gadepall/morse/main.tex

\documentclass[conference]{IEEEtran}
\usepackage{cite}
\usepackage{amsmath,amssymb,amsfonts}
\usepackage{graphicx}
\usepackage{textcomp}
\usepackage{xcolor}
\usepackage{listings}
\usepackage{url}
\usepackage{xurl}
\usepackage{hyperref}
\usepackage{tikz}
\usepackage{algorithm}
\usepackage{algpseudocode}
\usepackage{pgfplots}
\pgfplotsset{compat=1.17}
\usetikzlibrary{shapes,arrows,positioning,calc}

% Define a soft background color for the code blocks
\definecolor{codebg}{RGB}{245,245,248}

% Code listing style configuration
\lstset{
  language=C++,
  backgroundcolor=\color{codebg}, 
  basicstyle=\ttfamily\scriptsize, 
  keywordstyle=\color{blue},
  commentstyle=\color{green!60!black},
  stringstyle=\color{purple},
  breaklines=true,
  showstringspaces=false,
  frame=single,
  rulecolor=\color{gray!50}, 
  xleftmargin=0.5em,  
  xrightmargin=0.5em, 
  captionpos=b
}

\begin{document}

\title{A Morse Code-based Optical Communication System}
%\title{Adaptive Optical Telemetry: Evolving from Visible Light Baselines to Infrared Stepwise Derivative Thresholding and Goertzel Filtering}

\author{
    \IEEEauthorblockN{
Kartik Lahoti, Puni Aditya and G V V Sharma}
    \IEEEauthorblockA{Department of Electrical Engineering, \\Indian Institute of Technology Hyderabad,\\ Kandi, India 502284 \\ gadepall@ee.iith.ac.in}
    
}

\maketitle

\begin{abstract}
%Optical wireless communication offers a license-free alternative to Radio Frequency (RF) systems. However, simple visible light links utilizing Light Dependent Resistors (LDRs) face significant challenges regarding ambient light interference and hardware latency. 
This paper outlines a comprehensive multi-stage development of a Morse Code On-Off Keying (OOK) system. We first establish a baseline Visible Light Communication (VLC) link to demonstrate the fundamental principles of communication over an optical link.  
%, documenting a maximum range of 27 cm and identifying the "Iceberg Effect" of signal truncation. 
Subsequently, 
%Phase II 
we introduce 
%the transition to the 
Infrared (IR) 
communication to extend the range and explore more advanced techniques to improve the system performance. 
This is done by using the Arduino as the transceiver platform.  Our communication scheme is successfully demonstrated for a range of up to 2 meters.
%spectrum coupled with Dynamic Thresholding algorithm for adaptive thresholding, extending the range to 1.57 meters indoors. Finally, Phase III addresses the critical limitation of direct solar interference by implementing a fully software-defined 2~kHz carrier wave and a digital Goertzel filter, successfully rejecting DC solar saturation without requiring complex commercial hardware filters.
\end{abstract}

\begin{IEEEkeywords}
Visible Light Communication (VLC), Infrared (IR), Deynamic Thresholding, Goertzel Algorithm, On-Off Keying (OOK), Adaptive Thresholding.
\end{IEEEkeywords}

\section{Introduction}
Wireless optical communication is highly dependent on clear Line-of-Sight (LoS) and a high Signal-to-Noise Ratio (SNR) \cite{elgala2011, ghassemlooy2012}. In low-cost embedded systems, a standard Light Emitting Diode (LED) paired with a Light Dependent Resistor (LDR) is commonly used to demonstrate data transfer. However, ambient environmental lighting introduces a severe DC bias into the receiver, and LDRs exhibit significant photo-conductive latency \cite{sewaiwar2015}. 
The novelty of this paper lies in its evolutionary approach to solving physical layer limitations, building upon foundational On-Off Keying (OOK) optical paradigms \cite{komine2004}. We first establish a baseline VLC system to document hardware-induced signal degradation, known as the "Iceberg Effect." Following this, we introduce an advanced Infrared (IR) iteration utilizing Dynamic Thresholding—a software-defined algorithm that tracks the environmental noise floor \cite{green2005}. Finally, to overcome severe outdoor solar interference \cite{rajagopal2012}, we introduce a Goertzel algorithm-based digital signal processing (DSP) approach, effectively turning a low-cost microcontroller into a software-defined radio for optical frequencies.

\subsection{Related Works and Novelty}
Standard commercial IR systems avoid ambient noise by utilizing 38kHz Carrier Waves and specialized TSOP receiver modules. While effective, these modules act as "black boxes" that strip the analog signal data away from the microcontroller, preventing custom low-level signal analysis. Conversely, standard unmodulated photodiode circuits use fixed analog thresholds that fail the moment room lighting changes. Our proposed Dynamic Thresholding and Goertzel implementations bridge this gap, retaining raw analog sampling while applying dynamic digital filters to reject ambient DC bias. The related block diagram is available in 
    Fig. \ref{fig:block}
\begin{figure}[htbp]
    \centering
    \resizebox{\columnwidth}{!}{
    \begin{tikzpicture}[node distance=1.2cm, auto, >=stealth]
        \tikzstyle{block} = [rectangle, draw, fill=blue!10, text width=6em, text centered, rounded corners, minimum height=3em]
        \tikzstyle{line} = [draw, -latex', thick]
        
        % TX Nodes
        \node [block] (mcu1) {TX MCU\\(Morse Encoder)};
        \node [block, right=of mcu1] (led) {LED/IR LED\\(OOK Driver)};
        
        % Channel
        \node [coordinate, right=2.5cm of led] (ch1) {}; 
        \node [coordinate, below=1.5cm of ch1] (ch2) {};
        
        % RX Nodes
        \node [block, below=1.5cm of led] (sensor) {LDR/PD\\(Voltage Divider)};
        \node [block, left=of sensor] (adc) {ADC\\(Sampling)};
        \node [block, below=of adc] (sdm) {Dynamic Threshold/Goertzel\\(Digital Filter)};
        \node [block, right=of sdm] (decoder) {Symbol\\Decoder};
        \node [block, right=of decoder] (disp) {7-Segment\\Display};

        % Paths
        \path [line] (mcu1) -- node {Digital} (led);
        \path [line, dashed, red] (led) -- node[above] {Optical Channel} (ch1) -- (ch2) -- (sensor);
        \path [line] (sensor) -- node[above] {Analog} (adc);
        \path [line] (adc) -- (sdm);
        \path [line] (sdm) -- node[above] {Pulses} (decoder);
        \path [line] (decoder) -- node[above] {Char} (disp);
    \end{tikzpicture}
    }
    \caption{System Block Diagram detailing the cross-layer flow from hardware transmission to the software-defined filtering and hardware output.}
    \label{fig:block}
\end{figure}
%\section{Hardware Configuration}

To ensure reproducibility, the system was tested using standard off-the-shelf components. The development was split into two hardware profiles as detailed in Table \ref{tab:components}.
\begin{table}[htbp]
\caption{List of Components}
\label{tab:components}
\centering
\begin{tabular}{|l|l|}
\hline
\textbf{Setup} & \textbf{Components} \\ \hline
\textbf{Common} & 2$\times$ Arduino UNO, \\
&  2$\times$ Breadboards, \\
& Resistors, \\
& Jumper Cables \\ \hline
\textbf{Visible} & 1$\times$ Red LED ($5\text{mm}$), \\
& 1$\times$ LDR ($5\text{mm}$) \\ \hline
\textbf{IR} & 1$\times$ 940-nm IR LED, \\
& 1$\times$ IR Photodiode (Reverse Bias) \\ \hline
\end{tabular}
\end{table}

\subsection{Baud Rate and Telemetry Applicability}
Morse code, utilizing OOK, possesses a fundamentally low baud rate compared to modern digital modulation schemes like UART or QAM. However, for specialized telemetry applications—such as underwater optical communication or low-cost sensor nodes—signal penetration and robustness take precedence over raw speed. The widened tolerance windows used in this paper's decoding logic demonstrate how low baud rate systems can reliably reconstruct highly degraded signals \cite{uysal2015}.

\section{System Model}
\subsection{Baseband Morse Encoding}
To establish a quantitative baseline for On-Off Keying (OOK) modulation, the system utilizes the standard international Morse code protocol. In this telemetry model, the transmitter's digital output pin toggles between a HIGH (active) and LOW (idle) state to construct characters. 

The protocol defines all signal durations relative to a single base time unit ($T_u$), which in our experimental setup is set to $200\text{ ms}$. The strict timing rules governing this variable-length baseband modulation are detailed in Table \ref{tab:morse_timing}. 

\begin{table}[htbp]
\caption{Standard Morse Protocol Timings ($T_u = 200\text{ ms}$)}
\label{tab:morse_timing}
\centering
\begin{tabular}{|l|c|l|}
\hline
\textbf{Protocol Element} & \textbf{Logic State} & \textbf{Duration} \\ \hline
Dot (Dit)                 & HIGH (ON)            & 1 $T_u$ ($200\text{ ms}$) \\ \hline
Dash (Dah)                & HIGH (ON)            & 3 $T_u$ ($600\text{ ms}$) \\ \hline
Intra-character gap       & LOW (OFF)            & 1 $T_u$ ($200\text{ ms}$) \\ \hline
Inter-character gap       & LOW (OFF)            & 3 $T_u$ ($600\text{ ms}$) \\ \hline
Inter-word gap            & LOW (OFF)            & 7 $T_u$ ($1400\text{ ms}$) \\ \hline
\end{tabular}
\end{table}

This baseband square wave serves as the fundamental logic envelope for all subsequent experimental phases. A visual representation of these timing constraints is illustrated in Fig. \ref{fig:morse_an} for the transmission of the word "AN".
\begin{figure}[htbp]
    \centering
    \resizebox{\columnwidth}{!}{
    \begin{tikzpicture}[scale=0.6]
        % Axes
        \draw[->] (-0.5,0) -- (14,0) node[right] {Time ($T_u$)};
        \draw[->] (0,-0.5) -- (0,2) node[above] {TX Pin Logic};

        % Ticks
        \foreach \x in {1,2,3,4,5,6,7,8,9,10,11,12,13}
            \draw (\x,0.1) -- (\x,-0.1) node[below, scale=0.7] {\x};

        % Logic High/Low labels
        \node[left, scale=0.8] at (0, 1) {HIGH (1)};
        \node[left, scale=0.8] at (0, 0.25) {LOW (0)};

        % Waveform for "A" (.-) and "N" (-.)
        \draw[thick, blue]
            (0,0) -- (0,1) -- (1,1)   % A: dit
            -- (1,0) -- (2,0)         % intra-gap
            -- (2,1) -- (5,1)         % A: dah
            -- (5,0) -- (8,0)         % inter-character gap
            -- (8,1) -- (11,1)        % N: dah
            -- (11,0) -- (12,0)       % intra-gap
            -- (12,1) -- (13,1)       % N: dit
            -- (13,0) -- (14,0);      % return to idle

        % Annotations
        \draw[<->, dashed, red] (0, 1.4) -- (5, 1.4) node[midway, above] {Letter 'A' ( $\cdot$ $\textbf{-}$ )};
        \draw[<->, dashed, red] (8, 1.4) -- (13, 1.4) node[midway, above] {Letter 'N' ( $\textbf{-}$ $\cdot$ )};
        \draw[<->, dashed, green!50!black] (5, 0.5) -- (8, 0.5) node[midway, above, scale=0.8] {3-$T_u$ Gap};

    \end{tikzpicture}
    }
    \caption{Baseband OOK transmission waveform for the word "AN", illustrating the strict 1:3 timing ratio of standard Morse protocol.}
    \label{fig:morse_an}
\end{figure}

\subsection{Hardware Setup}
    Fig. \ref{fig:ckt} shows the transceiver configuration used for various cases.  
\begin{itemize}
    \item Transmitter (TX): An Arduino microcontroller drives a standard visible/IR LED. The LED's anode connects to Digital Pin 5, while the cathode is grounded through a $220\Omega$ current-limiting resistor. 
    \item Receiver (RX): The optical sensor is a Light Dependent Resistor (LDR)/IR receiver (connected in reverse bias) arranged in a voltage divider. The 5V supply is connected to one leg of the receiver. The secondary leg connects to the Arduino's Analog Pin A0 and a pull-down resistor ($R$) connected to ground. 
\end{itemize}
    The corresponding details are available in 
Table \ref{tab:res_vs_dist}.
\begin{figure}[htbp]
    \centering
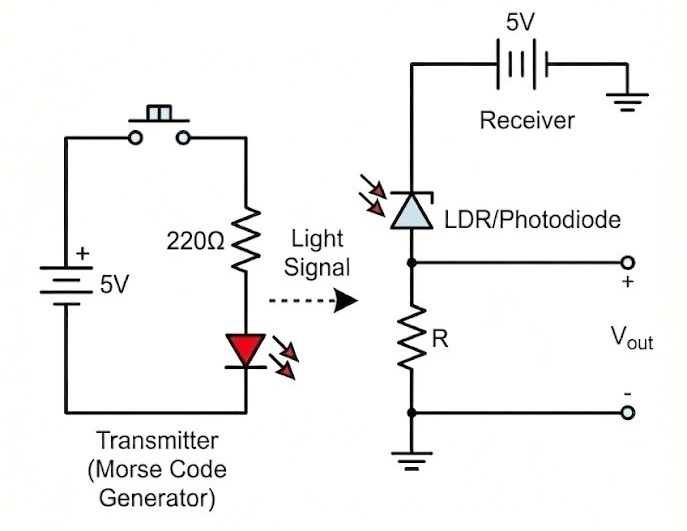
[picture p1: figs/circuit.jpeg]
    
    \caption{Circuit Diagram}
    \label{fig:ckt}
\end{figure}

\begin{table}[htbp]
\caption{Maximum Reliable Distance vs. Load Resistance}
\label{tab:res_vs_dist}
\centering
\begin{tabular}{|l|c|l|}
\hline
\textbf{Configuration} & \textbf{Load Resistor ($R$)} & \textbf{Maximum Range} \\ \hline
Visible Light & 10 k$\Omega$ & 27 cm \\ 
(LDR) & & \\ \hline
Baseband IR & 10 k$\Omega$ & $\approx$ 50 cm (47 cm) \\ \hline
Baseband IR & 1 M$\Omega$ & $\approx$ 2 m (157 cm) \\ \hline
Frequency- & 1 M$\Omega$ & $>$ 2 m (Slightly better) \\ 
Modulated IR & & \\ \hline
\end{tabular}
\end{table}

\section{Communication System}

\subsection{Visible Light Baseline}
%\subsubsection{Hardware Latency and The "Iceberg Effect"}
When bridging analog optical sensing and digital microcontrollers, signal truncation occurs. As shown in Fig. \ref{fig:iceberg}, an expected "Dah" signal transmitted for 600ms is detected for a fraction of that time. LDRs exhibit notable rise/fall latency, resulting in a trapezoidal curve. To counteract this, our receiver employs widened tolerance windows as listed in Table \ref{tab:morse_timing-modified}.
The baseline system achieved a maximum reliable transmission distance of only 11-12 cm in room light, and 27 cm in total darkness.
\begin{figure}[htbp]
    \centering
    \resizebox{\columnwidth}{!}{
    \begin{tikzpicture}[scale=0.8]
        \draw[->] (0,0) -- (8,0) node[right] {Time (ms)};
        \draw[->] (0,0) -- (0,5) node[above] {Analog Value};
        \draw[thick, blue, fill=blue!10] (0,0) -- (1.5,0) -- (2.5,4) -- (5.5,4) -- (7.5,0) -- (8,0);
        \node[blue] at (4, 2) {LDR Response Profile};
        \draw[red, thick, dashed] (0,3.5) -- (8,3.5);
        \node[red, right] at (8,3.5) {High Static Threshold};
        \draw[green!60!black, thick, dashed] (0,1.5) -- (8,1.5);
        \node[green!60!black, right] at (8,1.5) {Ideal Threshold};
        \draw[dotted, red] (2.375, 3.5) -- (2.375, -0.5); 
        \draw[dotted, red] (5.75, 3.5) -- (5.75, -0.5); 
        \draw[dotted, green!60!black] (1.875, 1.5) -- (1.875, -1);   
        \draw[dotted, green!60!black] (6.75, 1.5) -- (6.75, -1);   
        \draw[<->, red, thick] (2.375, -0.5) -- (5.75, -0.5) node[midway, below] {Detected: $\approx$330ms};
        \draw[<->, green!60!black, thick] (1.875, -1) -- (6.75, -1) node[midway, below] {Actual: $\approx$600ms};
    \end{tikzpicture}
    }
    \caption{The "Iceberg Effect" illustrating temporal truncation caused by improper static thresholding of an LDR signal.}
    \label{fig:iceberg}
\end{figure}

\begin{table}[htbp]
\caption{Adaptive Morse Protocol Timings to combat "Iceberg Effect"}
\label{tab:morse_timing-modified}
\centering
\begin{tabular}{|l|c|l|}
\hline
\textbf{Protocol Element} & \textbf{Logic State} & \textbf{Duration} \\ \hline
Dot (Dit)                 & HIGH (ON)            &  $150\text{ ms}$ \\ \hline
Dash (Dah)                & HIGH (ON)            &  $450\text{ ms}$ \\ \hline
Intra-character gap       & LOW (OFF)            &  $350\text{ ms}$ \\ \hline
Inter-character gap       & LOW (OFF)            &  $750\text{ ms}$ \\ \hline
Inter-word gap            & LOW (OFF)            &  $1600\text{ ms}$ \\ \hline
\end{tabular}
\end{table}
Instructions for flashing the firmware on the Arduinos for setting up the communication system are available in Appendix \ref{app:hardware}.

\subsection{Infrared Evolution and Dynamic Thresholding}

\begin{figure}[htbp]
    \centering
    % \resizebox forces the diagram to fit the column width exactly.
    % Requires \usepackage{graphicx} in your preamble.
    \resizebox{0.7\columnwidth}{!}{%
    \begin{tikzpicture}[
        auto, 
        node distance=0.8cm, % Reduced vertical/horizontal spacing
        >=latex,
        % Added font=\small to reduce text footprint
        block/.style={rectangle, draw, align=center, minimum height=2.5em, fill=gray!10, rounded corners=2pt, font=\small},
        sum/.style={draw, circle, minimum size=1.5em, inner sep=0pt, font=\large} % Style for the + symbol
    ]

        % 1. Define Nodes
        \node (analog) {$x(t)$};
        \node [block, right=0.4cm of analog] (adc) {ADC};
        
        % Split coordinate for the bypass line
        \node [coordinate, right=0.6cm of adc] (split) {};
        
        % Main vertical processing stack
        \node [block, right=0.6cm of split] (filter) {Moving Average\\Filter (Size $N$)};
        \node [sum, below=0.8cm of filter] (adder) {$+$}; % <-- Replaced Adder block with + symbol
        \node [block, below=0.8cm of adder] (comp) {Threshold\\($x[n] \gtrless \tau[n]$)}; 
        
        % Margin tucked closely to the right
        \node [block, right=0.4cm of adder] (margin) {Margin\\($\sigma$)};
        
        % Output moved BELOW the comparator to save horizontal space
        \node [block, below=0.6cm of comp] (output) {Output\\(H/L)};

        % 2. Draw Routing Paths
        % Analog input into ADC
        \draw [->] (analog) -- (adc);
        
        % ADC output to the split, labeled as the discrete x[n] sequence
        \draw [-] (adc) -- node[above, font=\small] {$x[n]$} (split);
        
        % Top path into filter
        \draw [->] (split) -- (filter.west);
        
        % Bypass line drops straight down from the split, then turns right into comparator
        \draw [->] (split) |- (comp.west);

        % Vertical logic flow
        \draw [->] (filter.south) -- node[left, font=\small] {$\mu[n]$} (adder.north);
        \draw [->] (adder.south) -- node[left, font=\small] {$\tau[n]$} (comp.north);
        
        % Side connections
        \draw [->] (margin.west) -- (adder.east);
        
        % Output connection (now vertical)
        \draw [->] (comp.south) -- (output.north);

    \end{tikzpicture}%
    }
    \caption{Block Diagram of Receiver used in IR with Dynamic Thresholding}
    \label{fig:dynamic_threshold_adc}
\end{figure}

\subsubsection{Hardware Optimization and Adaptive Filtering}
Operating in reverse-bias, the photodiode produces a photocurrent ($I_{pd}$) proportional to the incident photon flux; consequently, the voltage sampled by the ADC is governed by $V_{adc} = I_{pd} \times R$. By increasing $R$ from $10\text{ k}\Omega$ to $1\text{ M}\Omega$, sensitivity was maximized, extending the raw range to 1.57 meters indoors.

To isolate transmission pulses from fluctuating indoor IR noise, we implement a discrete-time Dynamic Thresholding algorithm. The core challenge is that the photodiode's ambient baseline is not zero; it is a floating DC offset that shifts as environmental lighting changes. To track this, the receiver converts the continuous-time analog voltage $x(t)$ into a discrete-time sequence by polling the Analog-to-Digital Converter (ADC) at designated intervals. Let $T_s$ represent this sampling period. The discrete sample index $n$ maps directly to physical continuous time via the relation $t = n T_s$, defining our sampled sequence as $x[n] = x(n T_s)$. 

The algorithm calculates a rolling local mean, over a circular buffer of $N$ samples to capture the slow-moving ambient noise floor:
\begin{equation}
    \tau[n] = \frac{1}{N} \sum_{i=0}^{N-1} x[n-i] + \sigma \label{eq:thres}
\end{equation}

This moving average inherently acts as a digital low-pass filter. To extract the high-frequency OOK pulses, a dynamic threshold $\tau[n]$ is established by adding a constant margin $\sigma$ to the local mean:

By dynamically adjusting the threshold relative to the moving baseline, the detection zone floats alongside ambient light shifts. The logic implementation is detailed in Algorithm \ref{alg:dynamic_threshold}, and the discrete sampling behavior is visualized in Fig. \ref{fig:dynamic_graph}.

\begin{algorithm}[htbp]
\caption{Dynamic Thresholding for OOK Demodulation}
\label{alg:dynamic_threshold}
\begin{algorithmic}[1]
\Require Discrete input sequence $x[n]$, Window size $N$, Margin $\sigma$
\State Initialize circular buffer $B$ of size $N$ to 0
\State Initialize running sum $S \leftarrow 0$
\For{each strictly timed sampling interval $n$}
    \State $S \leftarrow S - B[n \bmod N]$ \Comment{Remove oldest sample}
    \State $B[n \bmod N] \leftarrow x[n]$ \Comment{Insert new sample}
    \State $S \leftarrow S + x[n]$
    \State $\mu[n] \leftarrow S / N$ \Comment{Calculate local mean}
    \State $\tau[n] \leftarrow \mu[n] + \sigma$ \Comment{Set floating threshold}
    \If{$x[n] > \tau[n]$}
        \State Register logical HIGH (Pulse active)
    \Else
        \State Register logical LOW (Idle)
    \EndIf
\EndFor
\end{algorithmic}
\end{algorithm}

\begin{figure}[htbp]
    \centering
    \resizebox{\columnwidth}{!}{
    \begin{tikzpicture}[scale=1]
        % Axes
        \draw[->, thick] (-1,0) -- (68,0) node[right] {Sample ($n$)};
        \draw[->, thick] (0,-0.5) -- (0,6.8) node[above] {Amplitude};

        % Axis Ticks
        \foreach \x in {0, 10, 20, 30, 40, 50, 60} {
            \draw[thick] (\x, 0.1) -- (\x, -0.1) node[below, scale=0.8] {\x};
        }
        \node[below, scale=0.9] at (30, -0.7) {Discrete Sample Index ($n$) mapping to $t = n T_s$ ($T_s = 20$ ms)};

        % Local Mean - Rises VERY slowly because the buffer is massive (N=500)
        \draw[blue, thick] (0,0.5) .. controls (30,0.6) .. (65,0.8) node[right, align=center, scale=0.8] {Local Mean\\$\mu[n]$ (N=500)};

        % Dynamic Threshold
        \draw[red, thick, dashed] (0,2.0) .. controls (30,2.1) .. (65,2.3) node[right, align=center, scale=0.8] {Threshold\\$\tau[n]$};

        % Continuous underlying signal x(t) simulating exactly 'H' (....)
        \draw[orange!70, thick, rounded corners=1.5pt]
            (0, 0.5) -- (9.5, 0.6) % Initialization noise
            -- (9.8, 5.0) -- (19.2, 5.0) % Dit 1
            -- (19.5, 0.6) -- (29.5, 0.7) % Gap 1
            -- (29.8, 5.1) -- (39.2, 5.1) % Dit 2
            -- (39.5, 0.7) -- (49.5, 0.8) % Gap 2
            -- (49.8, 5.0) -- (59.2, 5.0) % Dit 3
            -- (59.5, 0.8) -- (65, 0.9);  % Gap 3

        \node[orange!90!black, above, scale=0.8] at (14, 3.5) {Continuous $x(t)$};

        % Discrete Signal Stems & Points x[n]
        % Exact 10-sample resolution per Tu (200ms Tu / 20ms Ts = 10 samples)
        \foreach \x in {0,1,...,9}   { \draw[gray, thin] (\x,0) -- (\x,0.55); \filldraw[black] (\x,0.55) circle (1.2pt); }
        \foreach \x in {10,11,...,19} { \draw[gray, thin] (\x,0) -- (\x,5.0); \filldraw[black] (\x,5.0) circle (1.2pt); }
        \foreach \x in {20,21,...,29} { \draw[gray, thin] (\x,0) -- (\x,0.65); \filldraw[black] (\x,0.65) circle (1.2pt); }
        \foreach \x in {30,31,...,39} { \draw[gray, thin] (\x,0) -- (\x,5.1); \filldraw[black] (\x,5.1) circle (1.2pt); }
        \foreach \x in {40,41,...,49} { \draw[gray, thin] (\x,0) -- (\x,0.75); \filldraw[black] (\x,0.75) circle (1.2pt); }
        \foreach \x in {50,51,...,59} { \draw[gray, thin] (\x,0) -- (\x,5.0); \filldraw[black] (\x,5.0) circle (1.2pt); }
        \foreach \x in {60,61,...,65} { \draw[gray, thin] (\x,0) -- (\x,0.85); \filldraw[black] (\x,0.85) circle (1.2pt); }

        % Timings annotations matching Arduino Code variables
        \draw[<->, thick, black!70] (10, 5.4) -- (19, 5.4) node[midway, above, scale=0.8] {Dit (1 $T_u$ = 10 samples)};
        \draw[<->, thick, black!70] (20, 1.2) -- (29, 1.2) node[midway, above, scale=0.8] {Intra-char Gap};
        \draw[<->, thick, black!70] (30, 5.5) -- (39, 5.5) node[midway, above, scale=0.8] {Dit (10 samples)};
        
        % Main character annotation
        \draw[<->, thick, blue!70!black] (10, 6.2) -- (59, 6.2) node[midway, above, scale=0.9] {\textbf{Start of 'H' (....) from "HELLO WORLD"}};

    \end{tikzpicture}
    }
    \caption{Exact mathematical mapping of the "HELLO WORLD" sequence. With a base time unit $T_u = 200$ ms and sample interval $T_s = 20$ ms, each standard Dit and Gap captures precisely 10 discrete samples. Because the buffer size is massive ($N=500$), the local mean $\mu[n]$ remains highly stable and does not climb high enough to clip the signal during pulses, completely preventing baseline wander.}
    \label{fig:dynamic_graph}
\end{figure}

% \subsubsection{Initialization and Training Sequence}
% Because the rolling buffer requires a stabilization period to accurately map the ambient noise floor, the system mandates an initialization phase prior to data transmission. The system starts with an assumed signal margin ($\sigma$), detailed in Table \ref{tab:assumed_thresholds}, to bootstrap the detection logic. During this phase, a known training sequence ("HELLO WORLD") is transmitted 10 times. 

% \begin{table}[htbp]
% \caption{Initial Assumed Threshold Margins ($\sigma$) Prior to Stabilization}
% \label{tab:assumed_thresholds}
% \centering
% \begin{tabular}{|l|c|l|}
% \hline
% \textbf{Ambient Environment} & \textbf{Assumed Margin ($\sigma$)} & \textbf{ADC Voltage Equivalent} \\ \hline
% Total Darkness & 30 & $\approx 0.15\text{V}$ \\ \hline
% Standard Indoor Lighting & 80 & $\approx 0.39\text{V}$ \\ \hline
% High Ambient (Near Window) & 150 & $\approx 0.73\text{V}$ \\ \hline
% \end{tabular}
% \end{table}

% Based on the timing ratios defined in Table \ref{tab:morse_timing}, this full 10-cycle training sequence spans 1110 $T_u$, equating to a deliberate 222-second pre-transmission window. This ensures the filter buffer fully saturates with representative environmental data before processing unknown payloads.

\subsubsection{Dynamic Thresholding Initialization and Training Sequence}
Because the rolling buffer requires a stabilization period to accurately map the ambient noise floor, the system mandates an initialization phase prior to data transmission. Initially, the system starts with an assumed, pre-defined threshold for the signal margin ($\sigma$), detailed in Table \ref{tab:assumed_thresholds}, to bootstrap the detection logic based on the expected ambient environment. During this initialization phase, a known training sequence—the phrase "HELLO WORLD"—is transmitted 10 times. 

\begin{table}[htbp]
\caption{Initial Assumed Signal Margins ($\sigma$) Prior to Stabilization (1 M$\Omega$ Setup)}
\label{tab:assumed_thresholds}
\centering
\begin{tabular}{|l|c|l|}
\hline
\textbf{Ambient Environment} & \textbf{Assumed Margin ($\sigma$)} & \textbf{ADC Voltage} \\ 
& & \textbf{Eqv. (5V)} \\ \hline
Total Darkness & 30 & $\approx 0.15\text{V}$ \\ \hline
Standard Indoor & 80 & $\approx 0.39\text{V}$ \\ 
Lighting & & \\ \hline
High Ambient & 150 & $\approx 0.73\text{V}$ \\ 
(Near Window)  & & \\ \hline
\end{tabular}
\end{table}

Based on the timing ratios defined in Table \ref{tab:morse_timing}, a single transmission of "HELLO WORLD" consumes exactly 111 $T_u$ (inclusive of all intra-character, inter-character, and inter-word gaps). Therefore, the full 10-cycle training sequence spans 1110 $T_u$. Given our baseline $T_u = 200\text{ ms}$, this equates to a deliberate 222-second pre-transmission window. This ensures the Dynamic Thresholding buffer ($V_{noise}$) fully saturates with representative environmental data, allowing the dynamic baseline to settle completely alongside the assumed margin before the receiver attempts to decode unknown payload characters.

\section{Amplitude Modulation}

\subsection{Limitations of Baseband Detection in Sunlight}
While unmodulated IR transmission functions indoors, it fails in direct sunlight. The sun acts as a continuous, high-intensity IR source that drives a massive steady-state photocurrent, saturating the receiver's 10-bit ADC and eliminating the dynamic range needed to detect Morse pulses. 

To prevent this "hard" saturation outdoors, the receiver's load resistor can be decreased (e.g., from $1\text{M}\Omega$ to $10\text{k}\Omega$). While this keeps the solar DC component within measurable bounds, it severely degrades the signal-to-noise ratio (SNR), reducing the intentional pulses to minute fluctuations on a massive DC floor. Recovering this attenuated signal requires transitioning from baseband amplitude tracking to frequency-selective filtering.

\subsection{Modulation}
To isolate the data from the solar baseline, we implement On-Off Keying (OOK), a fundamental form of Amplitude Modulation (AM). Instead of emitting a static DC pulse, the transmitter modulates the IR LED with a 2~kHz square wave carrier during every active Morse symbol.

This modulation shifts the transmission into the frequency domain:
\begin{itemize}
    \item \textbf{DC Offset (Sun):} Solar interference remains concentrated at 0~Hz.
    \item \textbf{Data Signal:} The Morse pulses are nested inside a 2000~Hz carrier band.
\end{itemize}
By toggling the LED at 2~kHz, the receiver can selectively filter out the 0~Hz solar bias and evaluate only the oscillating AC energy. Operating at a 50\% duty cycle also halves the active transmission power, extending battery life for remote nodes.

\begin{figure}[htbp]
    \centering
    \begin{tikzpicture}[scale=1]
        % Axes
        \draw[->] (0,0) -- (6,0) node[right] {Time};
        \draw[->] (0,-0.5) -- (0,1.5) node[above] {Amplitude};
        
        % Logic Envelope (Dashed)
        \draw[red, thick] (0,0) -- (1,0) -- (1,1) -- (3,1) -- (3,0) -- (4,0) -- (4,1) -- (5,1) -- (5,0);
        \node[red, scale=0.8] at (2,1.2) {Morse 'A' Envelope (.-)};

        % 2~kHz Square Wave Modulated Carrier (Dah)
        \draw[blue] (1,0) -- (1.1,0) -- (1.1,1) -- (1.2,1) -- (1.2,0) -- (1.3,0) -- (1.3,1) -- (1.4,1) -- (1.4,0) -- (1.5,0) -- (1.5,1) -- (1.6,1) -- (1.6,0) -- (1.7,0) -- (1.7,1) -- (1.8,1) -- (1.8,0) -- (1.9,0) -- (1.9,1) -- (2.0,1) -- (2.0,0) -- (2.1,0) -- (2.1,1) -- (2.2,1) -- (2.2,0) -- (2.3,0) -- (2.3,1) -- (2.4,1) -- (2.4,0) -- (2.5,0) -- (2.5,1) -- (2.6,1) -- (2.6,0) -- (2.7,0) -- (2.7,1) -- (2.8,1) -- (2.8,0) -- (2.9,0) -- (2.9,1) -- (3.0,1) -- (3.0,0);
        
        % 2~kHz Square Wave Modulated Carrier (Dit)
        \draw[blue] (4,0) -- (4.1,0) -- (4.1,1) -- (4.2,1) -- (4.2,0) -- (4.3,0) -- (4.3,1) -- (4.4,1) -- (4.4,0) -- (4.5,0) -- (4.5,1) -- (4.6,1) -- (4.6,0) -- (4.7,0) -- (4.7,1) -- (4.8,1) -- (4.8,0) -- (4.9,0) -- (4.9,1) -- (5.0,1) -- (5.0,0);
        
        \node[blue, align=center, scale=0.8] at (4.5,1.5) {2~kHz Square Wave\\Carrier};
        \node[red, align=center, scale=0.8] at (3,-0.3) {0~Hz Solar Bias Ignored};
    \end{tikzpicture}
    \caption{Amplitude Modulation: The Morse envelope gates a 2~kHz subcarrier, enabling frequency-selective filtering at the receiver.}
    \label{fig:modulation}
\end{figure}

\subsection{Demodulation}

\subsubsection{Receiver}
To detect the 2~kHz carrier digitally, the ADC prescaler is reduced from 128 to 16, accelerating the sampling rate ($f_s$) to $\approx 60\text{ kHz}$. This massive oversampling provides the resolution necessary for the Goertzel algorithm \cite{smith1997}, which we utilize as a computationally lightweight digital bandpass filter. 

The receiver pipeline is illustrated in Fig. \ref{fig:modulated_block}. For a given target frequency index $k$ and block size $N$, the algorithm computes the intermediate state $y[n]$ for each incoming sample $x[n]$ using the second-order difference equations \cite{goertzel}:
\begin{align}
    s[n] &= x[n] + 2 \cos\left(\frac{2\pi k}{N}\right) s[n-1] - s[n-2] \\
    y[n] &= s[n] - e^{-j\omega_{0}} s[n-1]
\end{align}
where $y[-1] = y[-2] = 0$ and $\omega_0 = \frac{2\pi k}{N}$.

\begin{figure}[htbp]
\centering
\resizebox{0.9\columnwidth}{!}{%
\begin{tikzpicture}[
    auto,
    block/.style={rectangle, draw, thick, text width=2.2cm, align=center, minimum height=1.2cm},
    arrow/.style={-stealth, thick}
]
% Top Row Nodes
\node (xt) {$x(t)$};
\node[block, right=0.8cm of xt] (adc) {ADC\\($f_s \approx 60$\,kHz)};
\node[block, right=1.4cm of adc] (bpf) {Goertzel\\Filter};

% Bottom Row Nodes
\node[block, below=1.0cm of bpf] (mag) {Magnitude\\Eval ($M^2$)};
\node[block, left=1.4cm of mag] (thresh) {$M^2 \gtrless \tau_{mag}$};
\node[left=0.8cm of thresh, align=center] (out) {Output};

% Arrows
\draw[arrow] (xt) -- (adc);
\draw[arrow] (adc) -- node[above] {$x[n]$} (bpf);
\draw[arrow] (bpf) -- node[right] {$y[n]$} (mag);
\draw[arrow] (mag) -- node[above] {$M^2$} (thresh);
\draw[arrow] (thresh) -- (out);
\end{tikzpicture}%
}
\caption{Block Diagram for Modulated IR Receiver ($\tau_{mag} = 15000$)}
\label{fig:modulated_block}
\end{figure}

After processing $N$ samples, the squared spectral magnitude $M^2$ at the target frequency is extracted:
\begin{align}
    M^2 &= y^2[N-1] + y^2[N-2] \\ 
	&- 2 \cos\left(\frac{2\pi k}{N}\right) y[N-1] y[N-2]
\end{align}

Using the squared magnitude bypasses the computational cost of floating-point square roots. 

A block size of $N=80$ provides a processing window of $\approx 1.33\text{ ms}$, ensuring temporal responsiveness for decoding Morse timings. This creates a bin resolution ($\Delta f = f_s / N$) of $750\text{ Hz}$. The index $k = \text{round}(N \cdot f_{target} / f_s) = 3$ centers the filter at $2250\text{ Hz}$. This wide main lobe comfortably captures the $2000\text{ Hz}$ carrier while aggressively suppressing out-of-band signals like 0~Hz DC sunlight and 120~Hz AC flicker.

\subsubsection{Static Thresholding and OOK Demodulation}
While $M^2$ theoretically approaches zero during transmission gaps, ADC quantization and thermal noise establish a low-level baseline. We apply an empirical static threshold ($\tau_{mag} = 15000$) to digitize the signal. 

Because constructive interference from a valid 2~kHz carrier produces $M^2$ values on the order of $10^5$, this threshold safely clears the noise floor while maintaining sensitivity to distant transmissions. The real-time OOK demodulation operates as a binary slicer:
\begin{equation}
    \text{Pulse Detected} = \begin{cases} 
      \text{True (HIGH)}, & \text{if } M^2 > \tau_{mag} \\
      \text{False (LOW)}, & \text{otherwise} 
   \end{cases}
\end{equation}
By filtering out the wandering DC bias mathematically, the Goertzel algorithm ensures absolute baseline stability. This eliminates the need for complex adaptive thresholding and allows robust OOK demodulation under variable lighting conditions.

\section{Experimental Results}

\subsection{Throughput and Bitrate Analysis}
We evaluated the efficiency of the three methods by transmitting a 44-byte (352-bit) test sentence. While the VLC setup required slower custom timings (101.8s) to account for photo-conductive latency, the transition to standard Morse timing in IR and Frequency-Modulated IR communication significantly improved throughput. Because Morse code utilizes variable-length OOK encoding, instantaneous throughput fluctuates based on character transmission length. A 44-byte pangram was explicitly chosen as the test payload to force the transmission of all alphabet symbol variants, thereby providing a normalized, worst-case representative average for system bitrate.

\begin{table}[htbp]
\caption{System Performance Comparison (44-Byte Sentence)}
\label{tab:bps}
\centering
\begin{tabular}{|l|c|c|l|}
\hline
\textbf{Receiver Mode of } & \textbf{Time (s)} & \textbf{Bitrate (bps)} & \textbf{Environment} \\ 
\textbf{Communication} & & \\ \hline
Visible Light & 101.8 & 3.46 & Dark/Indoor only \\ \hline
Baseband IR  & 81.4 & 4.32 & Indoor (Non-Solar) \\ \hline
Frequency- & 81.4 & 4.32 & \textbf{Direct Sunlight} \\ 
Modulated IR  & & \\ \hline
\end{tabular}
\end{table}

As shown in Table \ref{tab:bps}, Frequency-Modulated IR maintains the peak bitrate of 4.32 bps even in high-solar environments where VLC and Baseband IR systems experience complete signal saturation and $<10$\% decoding accuracy.

\subsection{Range Analysis}
The integration of impedance-tuned hardware with software-defined filtering yielded profound improvements. As illustrated in Fig. \ref{fig:graph}, the visible light baseline failed abruptly at 27 cm. The unoptimized IR setup ($10\text{k}\Omega$) reached 47 cm. The fully optimized IR-Dynamic Thresholding setup ($1\text{M}\Omega$) successfully maintained 100\% decoding accuracy up to 157 cm indoors. Decoding accuracy was empirically measured as the percentage of correctly reconstructed characters from the 44-byte test payload at varying distances.

\begin{figure}[htbp]
    \centering
    \resizebox{0.9\columnwidth}{!}{
    \begin{tikzpicture}
        \begin{axis}[
            xlabel={Transmission Distance (cm)},
            ylabel={Decoding Accuracy (\%)},
            xmin=0, xmax=180,
            ymin=0, ymax=110,
            legend pos=south west,
            grid=both,
            mark size=2.5pt
        ]
        \addplot[color=red, mark=square*] coordinates {(0,100) (15,100) (27,100) (30,0)}; 
        \addplot[color=blue, mark=triangle*] coordinates {(0,100) (30,100) (47,100) (52,0)}; 
        \addplot[color=green!60!black, mark=*] coordinates {(0,100) (100,100) (157,100) (165,0)}; 
        \legend{Visible (LDR), IR ($10\text{k}\Omega$), IR ($1\text{M}\Omega$)}
        \end{axis}
    \end{tikzpicture}
    }
    \caption{Comparative analysis of decoding accuracy over distance across the configurations.}
    \label{fig:graph}
\end{figure}

% \section{Conclusion and Future Work}
% This paper presented an evolutionary approach to overcoming the physical layer limitations of low-cost optical wireless communication. By systematically advancing from a basic visible light LDR circuit to an Infrared Dynamic Thresholding method, we mitigated indoor thermal noise and extended the range up to 2m. The implementation of a software-defined Goertzel filter on the 8-bit ATmega328P architecture proved to be the most robust solution. By shifting from hardware-reliant IR sensing to digital signal processing, the system successfully bypassed the 0Hz DC saturation caused by direct sunlight. This "Virtual Filter" approach allows low-cost microcontrollers to achieve high-selectivity communication that traditionally requires expensive specialized hardware. Future work will focus on optimizing the Goertzel block size ($N$) to further increase the bitrate while maintaining the noise-rejection benefits of the software-defined optical link.

\section{Conclusion and Future Work}
This paper demonstrated a systematic progression in overcoming the physical layer limitations of low-cost optical wireless communication. By evolving from basic visible light sensing to an adaptive Infrared system, we mitigated photo-conductive latency and indoor thermal noise. By shifting the complexity from hardware to a software-defined paradigm—utilizing 2~kHz OOK modulation and an optimized Goertzel digital filter—the system successfully maintained 100\% decoding accuracy at ranges up to 2m, even under direct solar interference. This "virtual filter" approach highlights the potential for low-power microcontrollers to perform sophisticated signal recovery in high-noise environments without requiring specialized commercial hardware. Future work will explore real-time transmission and increasing the baud rate, communication range as well as security.  Further, we plan to integrate the communication modules with a mobile phone for realtime text transfer. 

\bibliographystyle{IEEEtran}
\bibliography{references}

\appendices

\section{}
\label{app:hardware}

\begin{enumerate}
\item The code can be uploaded to the Arduino UNO using \texttt{PlatformIO}. Setup two project directories - one for transmitter and one for receiver.
	\begin{lstlisting}[language=bash]
	pio project init --board uno
    \end{lstlisting}
\item For source codes of transmitter and receiver, refer to the \texttt{tran} and \texttt{rec} respectively from
\begin{itemize}
\item \fbox{\parbox{\linewidth}{\url{https://github.com/gadepall/morse/codes/VLC}
}} for Visible Light Communication
\item \fbox{\parbox{\linewidth}{\url{https://github.com/gadepall/morse/codes/IR}
}} for Baseband IR Communication
\item \fbox{\parbox{\linewidth}{\url{https://github.com/gadepall/morse/codes/ModulatedIR}
}} for Modulated IR Communication
\end{itemize}
\item Copy the source code for the transmitter and receiver into \texttt{src/main.cpp} file in the respective project directories. The source codes are available in the above respective directories.
\item First upload the code to the receiver and then the transmitter. The text data to be transmitted can be input into the string in transmitter code.
\item Upload the code using the following command.
	\begin{lstlisting}[language=bash]
	pio run -t upload
    \end{lstlisting}
    
\end{enumerate}

\end{document}
