gadepall/morse/main.pdf

# A Morse Code-based Optical Communication System

Kartik Lahoti, Puni Aditya and G V V Sharma Department of Electrical Engineering, Indian Institute of Technology Hyderabad, Kandi, India 502284
gadepall@ee.iith.ac.in

Abstract—This paper outlines a comprehensive multi-stage development of a Morse Code On-Off Keying (OOK) system. We first establish a baseline Visible Light Communication (VLC) link to demonstrate the fundamental principles of communication over an optical link. Subsequently, we introduce Infrared (IR) communication to extend the range and explore more advanced techniques to improve the system performance. This is done by using the Arduino as the transceiver platform. Our communication scheme is successfully demonstrated for a range of up to 2 meters.
Index Terms—Visible Light Communication (VLC), Infrared (IR), Deynamic Thresholding, Goertzel Algorithm, On-Off Keying (OOK), Adaptive Thresholding.
I. INTRODUCTION
Wireless optical communication is highly dependent on clear Line-of-Sight (LoS) and a high Signal-to-Noise Ratio (SNR) [1], [2]. In low-cost embedded systems, a standard Light Emitting Diode (LED) paired with a Light Dependent Resistor (LDR) is commonly used to demonstrate data transfer. However, ambient environmental lighting introduces a severe DC bias into the receiver, and LDRs exhibit significant photo-conductive latency [3]. The novelty of this paper lies in its evolutionary approach to solving physical layer limitations, building upon foundational On-Off Keying (OOK) optical paradigms [4]. We first establish a baseline VLC system to document hardware-induced signal degradation, known as the ”Iceberg Effect.” Following this, we introduce an advanced Infrared (IR) iteration utilizing Dynamic Thresholding—a software-defined algorithm that tracks the environmental noise floor [5]. Finally, to overcome severe outdoor solar interference [6], we introduce a Goertzel algorithm-based digital signal processing (DSP) approach, effectively turning a low-cost microcontroller into a software-defined radio for optical frequencies.
A. Related Works and Novelty
Standard commercial IR systems avoid ambient noise by utilizing 38kHz Carrier Waves and specialized TSOP receiver modules. While effective, these modules act as ”black boxes” that strip the analog signal data away from the microcontroller, preventing custom low-level signal analysis. Conversely, standard unmodulated photodiode circuits use fixed analog thresholds that fail the moment room lighting changes. Our proposed

Dynamic Thresholding and Goertzel implementations bridge this gap, retaining raw analog sampling while applying dynamic digital filters to reject ambient DC bias. The related block diagram is available in Fig. 1

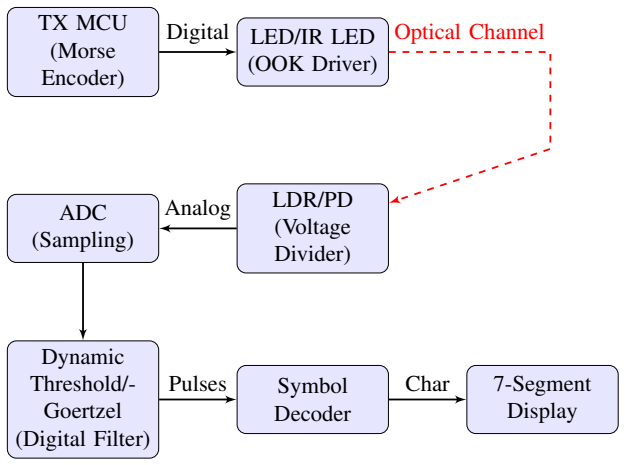
[picture p2: figure]
TX MCU (Morse Encoder); LED/IR LED (OOK Driver); LDR/PD (Voltage Divider); ADC (Sampling); Dynamic Threshold/- Goertzel (Digital Filter); Symbol Decoder; 7-Segment Display; Digital; Optical Channel; Analog; Pulses; Char

Fig. 1. System Block Diagram detailing the cross-layer flow from hardware transmission to the software-defined filtering and hardware output.

To ensure reproducibility, the system was tested using standard off-the-shelf components. The development was split into two hardware profiles as detailed in Table I.

TABLE I
LIST OF COMPONENTS
Setup | Components
Common | 2× Arduino UNO, 2× Breadboards, Resistors, Jumper Cables
Visible | 1× Red LED (5mm), 1× LDR (5mm)
IR | 1× 940-nm IR LED, 1× IR Photodiode (Reverse Bias)
B. Baud Rate and Telemetry Applicability
Morse code, utilizing OOK, possesses a fundamentally low baud rate compared to modern digital modulation schemes like UART or QAM. However, for specialized telemetry applications—such as underwater optical communication or low-cost sensor nodes—signal penetration and robustness take precedence over raw speed. The widened tolerance windows used in this paper’s decoding logic demonstrate how low baud rate systems can reliably reconstruct highly degraded signals [7].

II. SYSTEM MODEL
A. Baseband Morse Encoding
To establish a quantitative baseline for On-Off Keying (OOK) modulation, the system utilizes the standard international Morse code protocol. In this telemetry model, the transmitter’s digital output pin toggles between a HIGH (active) and LOW (idle) state to construct characters.
The protocol defines all signal durations relative to a single base time unit (Tu), which in our experimental setup is set to 200 ms. The strict timing rules governing this variable-length baseband modulation are detailed in Table II.

TABLE II
STANDARD MORSE PROTOCOL TIMINGS (Tu = 200 MS)
Protocol Element | Logic State | Duration
Dot (Dit) | HIGH (ON) | 1 Tu (200 ms)
Dash (Dah) | HIGH (ON) | 3 Tu (600 ms)
Intra-character gap | LOW (OFF) | 1 Tu (200 ms)
Inter-character gap | LOW (OFF) | 3 Tu (600 ms)
Inter-word gap | LOW (OFF) | 7 Tu (1400 ms)

This baseband square wave serves as the fundamental logic envelope for all subsequent experimental phases. A visual representation of these timing constraints is illustrated in Fig. 2 for the transmission of the word ”AN”.

Time (Tu)

TX Pin Logic

1 | 2 | 3 | 4 | 5 | 6 | 7 | 8 | 9 | 10 | 11 | 12 | 13

HIGH (1)

LOW (0)

Letter ’A’ ( · - ) | Letter ’N’ ( - · )

3-Tu Gap

Fig. 2. Baseband OOK transmission waveform for the word ”AN”, illustrating the strict 1:3 timing ratio of standard Morse protocol.

B. Hardware Setup
Fig. 3 shows the transceiver configuration used for various cases.
- Transmitter (TX): An Arduino microcontroller drives a standard visible/IR LED. The LED’s anode connects to Digital Pin 5, while the cathode is grounded through a 220Ω current-limiting resistor.
- Receiver (RX): The optical sensor is a Light Dependent Resistor (LDR)/IR receiver (connected in reverse bias) arranged in a voltage divider. The 5V supply is connected to one leg of the receiver. The secondary leg connects to the Arduino’s Analog Pin A0 and a pull-down resistor
(R) connected to ground.
The corresponding details are available in Table III.


Fig. 3. Circuit Diagram

TABLE III
MAXIMUM RELIABLE DISTANCE VS. LOAD RESISTANCE
Configuration | Load Resistor (R) | Maximum Range
Visible Light (LDR) | 10 kΩ | 27 cm
Baseband IR | 10 kΩ | ≈ 50 cm (47 cm)
Baseband IR | 1 MΩ | ≈ 2 m (157 cm)
Frequency-Modulated IR | 1 MΩ | > 2 m (Slightly better)

III. COMMUNICATION SYSTEM

A. Visible Light Baseline

When bridging analog optical sensing and digital microcontrollers, signal truncation occurs. As shown in Fig. 4, an expected ”Dah” signal transmitted for 600ms is detected for a fraction of that time. LDRs exhibit notable rise/fall latency, resulting in a trapezoidal curve. To counteract this, our receiver employs widened tolerance windows as listed in Table IV. The baseline system achieved a maximum reliable transmission distance of only 11-12 cm in room light, and 27 cm in total darkness.

Time (ms)

Analog Value

LDR Response Profile

High Static Threshold

Ideal Threshold

Detected: ≈330ms
Actual: ≈600ms

Fig. 4. The ”Iceberg Effect” illustrating temporal truncation caused by improper static thresholding of an LDR signal.

Instructions for flashing the firmware on the Arduinos for setting up the communication system are available in Appendix A.

TABLE IV
ADAPTIVE MORSE PROTOCOL TIMINGS TO COMBAT ”ICEBERG EFFECT”
Protocol Element | Logic State | Duration
Dot (Dit) | HIGH (ON) | 150 ms
Dash (Dah) | HIGH (ON) | 450 ms
Intra-character gap | LOW (OFF) | 350 ms
Inter-character gap | LOW (OFF) | 750 ms
Inter-word gap | LOW (OFF) | 1600 ms

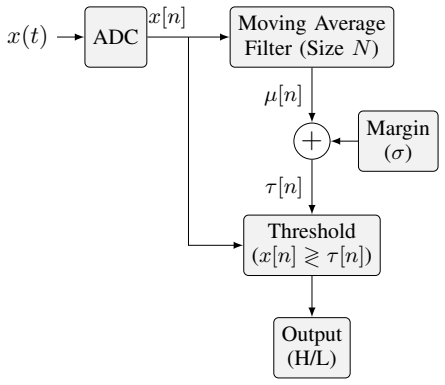
[picture p3: figure]
ADC; Moving Average; Filter (Size N); Threshold (x[n] ≷ τ [n]); Margin (σ); Output (H/L)

Fig. 5. Block Diagram of Receiver used in IR with Dynamic Thresholding

B. Infrared Evolution and Dynamic Thresholding
1) Hardware Optimization and Adaptive Filtering: Operating in reverse-bias, the photodiode produces a photocurrent (Ipd) proportional to the incident photon flux; consequently, the voltage sampled by the ADC is governed by Vadc = Ipd×R. By increasing R from 10 kΩ to 1 MΩ, sensitivity was maximized, extending the raw range to 1.57 meters indoors. To isolate transmission pulses from fluctuating indoor IR noise, we implement a discrete-time Dynamic Thresholding algorithm. The core challenge is that the photodiode’s ambient baseline is not zero; it is a floating DC offset that shifts as environmental lighting changes. To track this, the receiver converts the continuous-time analog voltage x(t) into a discrete-time sequence by polling the Analog-to-Digital Converter (ADC) at designated intervals. Let Ts represent this sampling period. The discrete sample index n maps directly to physical continuous time via the relation t = nTs, defining our sampled sequence as x[n] = x(nTs).
The algorithm calculates a rolling local mean, over a circular buffer of N samples to capture the slow-moving ambient noise floor:
τ [n] = 1
N

N

X⁻¹

i=0

x[n − i] + σ | (1)

This moving average inherently acts as a digital low-pass filter. To extract the high-frequency OOK pulses, a dynamic threshold τ [n] is established by adding a constant margin σ to the local mean:
By dynamically adjusting the threshold relative to the moving baseline, the detection zone floats alongside ambient light shifts. The logic implementation is detailed in Algorithm 1, and the discrete sampling behavior is visualized in Fig. 6.

Algorithm 1 Dynamic Thresholding for OOK Demodulation Require: Discrete input sequence x[n], Window size N, Margin σ
1: Initialize circular buffer B of size N to 0
2: Initialize running sum S ← 0
3: for each strictly timed sampling interval n do
4: | S ← S − B[n mod N] | ▷ Remove oldest sample
5: | B[n mod N] ← x[n] | ▷ Insert new sample
6: | S ← S + x[n]
7: | µ[n] ← S/N | ▷ Calculate local mean
8: | τ [n] ← µ[n] + σ | ▷ Set floating threshold
9: | if x[n] > τ [n] then
10: | Register logical HIGH (Pulse active)
11: | else
12: | Register logical LOW (Idle)
13: | end if
14: end for

Sample (n)

Amplitude

0 | 10 | 20 | 30 | 40 | 50 | 60 Discrete Sample Index (n) mapping to t = nTs (Ts = 20 ms)

Local Mean µ[n] (N=500)

Threshold
τ [n]

Continuous x(t)

Dit (1 Tu = 10 samples)

Intra-char Gap

Dit (10 samples) Start of ’H’ (....) from ”HELLO WORLD”

Fig. 6. Exact mathematical mapping of the ”HELLO WORLD” sequence. With a base time unit Tu = 200 ms and sample interval Ts = 20 ms, each standard Dit and Gap captures precisely 10 discrete samples. Because the buffer size is massive (N = 500), the local mean µ[n] remains highly stable and does not climb high enough to clip the signal during pulses, completely preventing baseline wander.

2) Dynamic Thresholding Initialization and Training Sequence: Because the rolling buffer requires a stabilization period to accurately map the ambient noise floor, the system mandates an initialization phase prior to data transmission. Initially, the system starts with an assumed, pre-defined threshold for the signal margin (σ), detailed in Table V, to bootstrap the detection logic based on the expected ambient environment. During this initialization phase, a known training sequence—the phrase ”HELLO WORLD”—is transmitted 10 times.

TABLE V
INITIAL ASSUMED SIGNAL MARGINS (σ) PRIOR TO STABILIZATION (1
MΩ SETUP)
Ambient Environment | Assumed Margin (σ) | ADC Voltage Eqv. (5V)
Total Darkness | 30 | ≈ 0.15V
Standard Indoor Lighting | 80 | ≈ 0.39V
High Ambient (Near Window) | 150 | ≈ 0.73V

Based on the timing ratios defined in Table II, a single transmission of ”HELLO WORLD” consumes exactly 111 Tu (inclusive of all intra-character, inter-character, and inter-word gaps). Therefore, the full 10-cycle training sequence spans 1110 Tu. Given our baseline Tu = 200 ms, this equates to a deliberate 222-second pre-transmission window. This ensures the Dynamic Thresholding buffer (Vnoise) fully saturates with representative environmental data, allowing the dynamic baseline to settle completely alongside the assumed margin before the receiver attempts to decode unknown payload characters.

IV. AMPLITUDE MODULATION

A. Limitations of Baseband Detection in Sunlight

While unmodulated IR transmission functions indoors, it fails in direct sunlight. The sun acts as a continuous, highintensity IR source that drives a massive steady-state photocurrent, saturating the receiver’s 10-bit ADC and eliminating the dynamic range needed to detect Morse pulses.
To prevent this ”hard” saturation outdoors, the receiver’s load resistor can be decreased (e.g., from 1MΩ to 10kΩ). While this keeps the solar DC component within measurable bounds, it severely degrades the signal-to-noise ratio (SNR), reducing the intentional pulses to minute fluctuations on a massive DC floor. Recovering this attenuated signal requires transitioning from baseband amplitude tracking to frequency-selective filtering.
B. Modulation

To isolate the data from the solar baseline, we implement On-Off Keying (OOK), a fundamental form of Amplitude Modulation (AM). Instead of emitting a static DC pulse, the transmitter modulates the IR LED with a 2 kHz square wave carrier during every active Morse symbol.
This modulation shifts the transmission into the frequency domain:
- DC Offset (Sun): Solar interference remains concentrated at 0 Hz.
- Data Signal: The Morse pulses are nested inside a 2000 Hz carrier band.

By toggling the LED at 2 kHz, the receiver can selectively filter out the 0 Hz solar bias and evaluate only the oscillating AC energy. Operating at a 50% duty cycle also halves the active transmission power, extending battery life for remote nodes.

Time

Amplitude

Morse ’A’ Envelope (.-)

2 kHz Square Wave
Carrier

0 Hz Solar Bias Ignored

Fig. 7. Amplitude Modulation: The Morse envelope gates a 2 kHz subcarrier, enabling frequency-selective filtering at the receiver.

C. Demodulation
1) Receiver: To detect the 2 kHz carrier digitally, the ADC prescaler is reduced from 128 to 16, accelerating the sampling rate (fs) to ≈ 60 kHz. This massive oversampling provides the resolution necessary for the Goertzel algorithm [8], which we utilize as a computationally lightweight digital bandpass filter. The receiver pipeline is illustrated in Fig. 8. For a given target frequency index k and block size N, the algorithm computes the intermediate state y[n] for each incoming sample x[n] using the second-order difference equations [9]:

s[n] = x[n] + 2 cos
2πk
N
s[n − 1] − s[n − 2] (2)

y[n] = s[n] − e

−jω0 s[n − 1] | (3)

where y[−1] = y[−2] = 0 and ω0 =

2πk
N

x(t)

ADC
(fs ≈ 60 kHz)

Goertzel
Filter

Magnitude
Eval (M²
)
Output | M² ≷ τmag

x[n]

y[n]

M²

Fig. 8. Block Diagram for Modulated IR Receiver (τmag = 15000)

After processing N samples, the squared spectral magnitude M²
at the target frequency is extracted:

M² = y

2
[N − 1] + y

2
[N − 2] | (4)
− 2 cos
2πk
N
y[N − 1]y[N − 2] | (5)

Using the squared magnitude bypasses the computational cost of floating-point square roots.
A block size of N = 80 provides a processing window of ≈ 1.33 ms, ensuring temporal responsiveness for decoding Morse timings. This creates a bin resolution (∆f = fs/N) of 750 Hz. The index k = round(N · ftarget/fs) = 3 centers the filter at 2250 Hz. This wide main lobe comfortably captures the 2000 Hz carrier while aggressively suppressing out-ofband signals like 0 Hz DC sunlight and 120 Hz AC flicker.
2) Static Thresholding and OOK Demodulation: While M² theoretically approaches zero during transmission gaps, ADC quantization and thermal noise establish a low-level baseline. We apply an empirical static threshold (τmag = 15000) to digitize the signal.
Because constructive interference from a valid 2 kHz carrier produces M² values on the order of 10⁵
, this threshold safely
clears the noise floor while maintaining sensitivity to distant transmissions. The real-time OOK demodulation operates as a binary slicer:

Pulse Detected =

(
True (HIGH), if M² > τmag False (LOW), otherwise | (6)

By filtering out the wandering DC bias mathematically, the Goertzel algorithm ensures absolute baseline stability. This eliminates the need for complex adaptive thresholding and allows robust OOK demodulation under variable lighting conditions.

V. EXPERIMENTAL RESULTS
A. Throughput and Bitrate Analysis
We evaluated the efficiency of the three methods by transmitting a 44-byte (352-bit) test sentence. While the VLC setup required slower custom timings (101.8s) to account for photo-conductive latency, the transition to standard Morse timing in IR and Frequency-Modulated IR communication significantly improved throughput. Because Morse code utilizes variable-length OOK encoding, instantaneous throughput fluctuates based on character transmission length. A 44-byte pangram was explicitly chosen as the test payload to force the transmission of all alphabet symbol variants, thereby providing a normalized, worst-case representative average for system bitrate.

TABLE VI
SYSTEM PERFORMANCE COMPARISON (44-BYTE SENTENCE)
Receiver Mode of | Time (s) | Bitrate (bps) | Environment
Communication
Visible Light | 101.8 | 3.46 | Dark/Indoor only
Baseband IR | 81.4 | 4.32 | Indoor (Non-Solar)

Modulated IR

Frequency- | 81.4 | 4.32 | Direct Sunlight

As shown in Table VI, Frequency-Modulated IR maintains the peak bitrate of 4.32 bps even in high-solar environments where VLC and Baseband IR systems experience complete signal saturation and < 10% decoding accuracy.

B. Range Analysis
The integration of impedance-tuned hardware with software-defined filtering yielded profound improvements. As illustrated in Fig. 9, the visible light baseline failed abruptly at 27 cm. The unoptimized IR setup (10kΩ) reached 47 cm. The fully optimized IR-Dynamic Thresholding setup (1MΩ) successfully maintained 100% decoding accuracy up to 157 cm indoors. Decoding accuracy was empirically measured as the percentage of correctly reconstructed characters from the 44-byte test payload at varying distances.

VI. CONCLUSION AND FUTURE WORK
This paper demonstrated a systematic progression in overcoming the physical layer limitations of low-cost optical wireless communication. By evolving from basic visible light sensing to an adaptive Infrared system, we mitigated photo-conductive latency and indoor thermal noise. By shifting the complexity from hardware to a software-defined paradigm—utilizing 2 kHz OOK modulation and an optimized Goertzel digital filter—the system successfully maintained 100% decoding accuracy at ranges up to 2m, even under direct solar interference. This ”virtual filter” approach highlights the

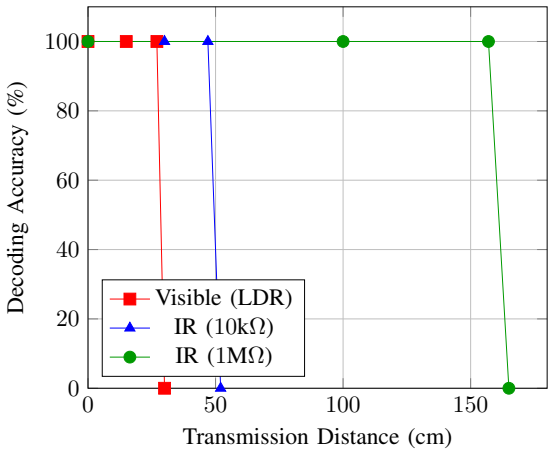
[picture p4: figure]
Transmission Distance (cm); Decoding Accuracy (%); Visible (LDR) IR (10kΩ) IR (1MΩ)

Fig. 9. Comparative analysis of decoding accuracy over distance across the configurations.

potential for low-power microcontrollers to perform sophisticated signal recovery in high-noise environments without requiring specialized commercial hardware. Future work will explore real-time transmission and increasing the baud rate, communication range as well as security. Further, we plan to integrate the communication modules with a mobile phone for realtime text transfer.

REFERENCES

[1] H. Elgala, R. Mesleh, and H. Haas, “Indoor optical wireless communication: potential and state-of-the-art,” IEEE Communications Magazine, vol. 49, no. 9, pp. 56–62, Sep 2011.
[2] Z. Ghassemlooy, W. Popoola, and S. Rajbhandari, Optical Wireless Communications: System and Channel Modelling with MATLAB. Boca Raton, FL, USA: CRC Press, 2012.
[3] A. Sewaiwar, S. V. Tiwari, and Y. Chung, “Smart led-based ambient light adaptive vlc system,” Optics Express, vol. 23, no. 19, pp. 24 456–24 465, 2015.
[4] T. Komine and M. Nakagawa, “Fundamental analysis for visible-light communication system using led lights,” IEEE Transactions on Consumer Electronics, vol. 50, no. 1, pp. 100–107, Feb 2004.
[5] R. J. Green, H. Joshi, M. D. Higgins, and M. S. Leeson, “Adaptive thresholding for optical wireless receivers,” IEE Proceedings - Optoelectronics, vol. 152, no. 6, pp. 317–321, Dec 2005.
[6] S. Rajagopal, R. D. Roberts, and S.-K. Lim, “Ieee 802.15.7 visible light communication: modulation schemes and dimming support,” IEEE Communications Magazine, vol. 50, no. 3, pp. 72–82, Mar 2012.
[7] M. Uysal, F. Miramirkhani, T. Baykas, and K. Qaraqe, “Visible light communication for vehicular networking: Performance study of a v2v system using a low-complexity receiver,” IEEE Vehicular Technology Magazine, vol. 10, no. 4, pp. 71–79, Dec 2015.
[8] S. W. Smith, The Scientist and Engineer’s Guide to Digital Signal Processing. San Diego, CA, USA: California Technical Publishing, 1997.
[9] Wikipedia contributors. (2024) Goertzel algorithm. [Online]. Accessed: May 20, 2024. [Online]. Available: https://en.wikipedia.org/wiki/Goertz el algorithm (https://en.wikipedia.org/wiki/Goertzel_algorithm)

APPENDIX A

1) The code can be uploaded to the Arduino UNO using PlatformIO. Setup two project directories - one for transmitter and one for receiver.

pio project init --board uno

2) For source codes of transmitter and receiver, refer to the tran and rec respectively from
- https://github.com/gadepall/morse/codes/VLC for Visible Light Communication
- https://github.com/gadepall/morse/codes/IR
for Baseband IR Communication

•

https://github.com/gadepall/morse/codes/Modulate dIR (https://github.com/gadepall/morse/codes/ModulatedIR)
for Modulated IR Communication
3) Copy the source code for the transmitter and receiver into src/main.cpp file in the respective project directories. The source codes are available in the above respective directories.
4) First upload the code to the receiver and then the transmitter. The text data to be transmitted can be input into the string in transmitter code.
5) Upload the code using the following command.

pio run -t upload
